himanivishwa/S3DUCKY/BOM/BOMS3DUCKY.csv

# | Reference | Part (from your BOM) | Footprint | Qty on board | Vendor | Product listed | Link | price | price in usd
1 | C1, C7 | 100nF | Capacitor_SMD:C_0805_2012Metric | 2 | Sharvi | 0.1uF/100nF 10V Capacitor – 0805 Package | https://sharvielectronics.com/product/0-1uf-100nf-10v-capacitor-0805-pack-of-10/ | 25 | 0.26
2 | C2, C5 | 10uF | Capacitor_SMD:C_0805_2012Metric | 2 | Sharvi | 10uF/10000nF 16V Capacitor – 0805 SMD Package | https://sharvielectronics.com/product/10uf-10000nf-16v-capacitor-%c2%b110-tolerance-0805x106k160ct-0805-package/ | 29.5 | 0.31
3 | C6 | 22uF | Capacitor_SMD:C_0805_2012Metric | 1 | Unsourced | 22uF 0805 X5R 10V | https://sharvielectronics.com/product/22uf-22000nf-50v-capacitor-%c2%b110-tolerance-0805b226k500ct-0805-package/ | 4.56 | 0.048
4 | D1 | RED LED | LED_SMD:LED_0805_2012Metric | 1 | Quartz | Red LED – SMD (0805 Package) – Pack of 50 | https://quartzcomponents.com/products/red-led-smd-0805-package-pack-of-50 | 25 | 0.26
5 | D2 | GREEN LED | LED_SMD:LED_0805_2012Metric | 1 | Quartz | Green LED – SMD (0805 Package) – Pack of 50 | https://quartzcomponents.com/collections/smd-leds/products/green-led-smd-0805-package-pack-of-50 | 24 | 0.26
6 | D3 | BLUE LED | LED_SMD:LED_0805_2012Metric | 1 | Quartz | Blue LED – SMD (0805 Package) – Pack of 50 | https://quartzcomponents.com/products/blue-led-smd-0805-package-pack-of-50 | 24 | 0.26
7 | J1, J3 | Conn_01x11_Pin (1x11 male header, 2.54 mm) | Connector_PinHeader_2.54mm:PinHeader_1x11_P2.54mm_Vertical | 2 | Unsourced | 1x40 break-away male header strip | n/a
8 | J2 | USB_A (male, through-hole) | usb_afoot:USB-AM-TH_AM90 | 1 | Robu | USB A-type Plug Male PCB R/A Connector (Pack of 5) | https://robu.in/product/usb-a-type-plug-male-pcb-r-a-connector-pack-of-5 | 5 | 0.053
9 | R3, R4, R5, R6 | 5.1k | Resistor_SMD:R_0805_2012Metric | 4 | Quartz | 5.1K ohm / 5K1 5% SMD Resistor 0805 (Pack of 20 Pieces) | https://quartzcomponents.com/collections/smd-resistors/products/5-1k-ohm-5k1-5-smd-resistor-0805-pack-of-20-pieces | 8 | 0.084
10 | SW1, SW2 | SW_Push (SMD tact switch ~3.9 × 3.0 mm) | smd_sw:SW-SMD_L3.9-W3.0-P4.45 | 2 | Unsourced | SMD tactile switch 3x4x2 mm (not found at the 4 shops) | https://robu.in/product/362-5mm-tactile-push-button-switch-20pcs/ | 25 | 0.26
11 | U1 | ESP32-S3-WROOM-1 | RF_Module:ESP32-S3-WROOM-1 | 1 | Robu | Espressif ESP32-S3-WROOM-1-N16R8 Module | https://robu.in/product/espressif-esp32-s3-wroom-1-n16r8-module | 449 | 4.73
12 | U2 | LD1117V (3.3 V, SOT-223 footprint) | Package_TO_SOT_SMD:SOT-223-3_TabPin2 | 1 | Robu | LM1117GS-3.3 – 3.3V 1A LDO regulator, SOT-223 (pin-compatible substitute) | https://robu.in/product/lm1117gs-3-3-3-3v-lm1117-1a-fixed-output-ldo-linear-voltage-regulator-4-pin-sot-223/ | 25 | 0.26
 |  |  |  |  |  | robu shipping |  | 49 | 0.52
 |  |  |  |  |  | quartz shipping + taxes |  | 74.58 | 0.79
 |  |  |  |  |  | sharvielectronics shipping + taxes |  | 68.2 | 0.72
 |  |  |  |  |  | jlc pcb |  | 379.78 | 4
 |  |  |  |  |  | pcb shipping |  | 626.64 | 6.6
 |  |  |  |  |  |  | Total | 1842.26 | 19.4
