himanivishwa/S3DUCKY/hardware/s3-ducky.kicad_pcb

## KiCad design hardware/s3-ducky.kicad_pcb (2026-10-26)

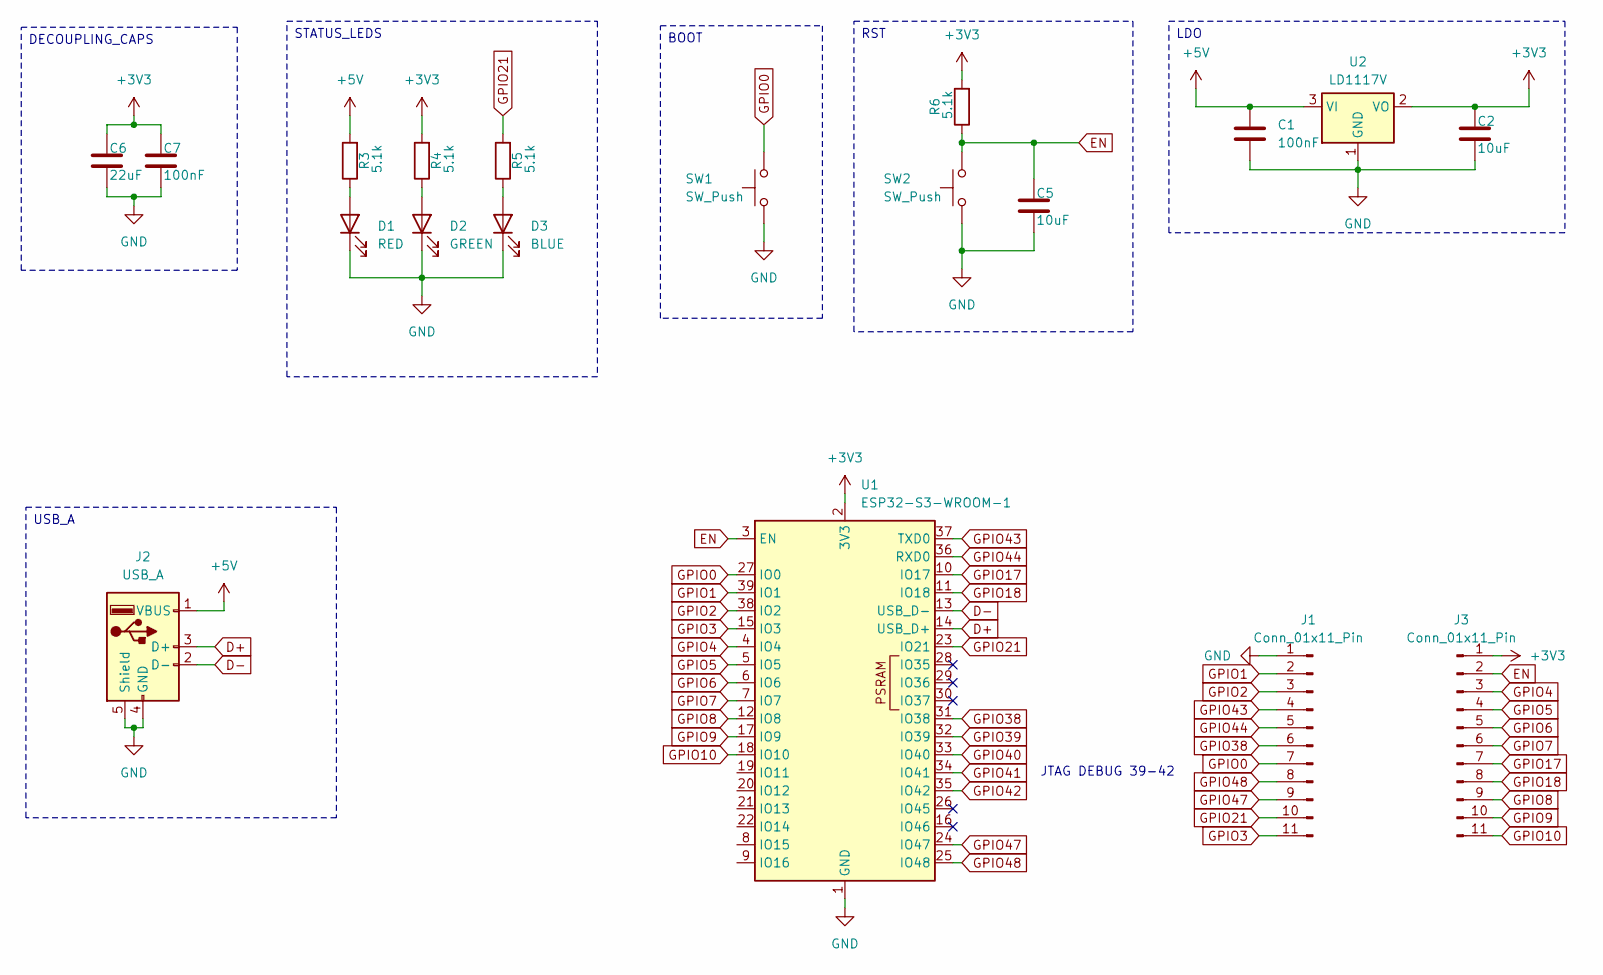
[picture p3: schematic s3-ducky.kicad_sch]

Parts:
C1, C7: 100nF; C_0805_2012Metric
C2, C5: 10uF; C_0805_2012Metric
C6: 22uF; C_0805_2012Metric
D1: RED; LED_0805_2012Metric
D2: GREEN; LED_0805_2012Metric
D3: BLUE; LED_0805_2012Metric
J1, J3: Conn_01x11_Pin; PinHeader_1x11_P2.54mm_Vertical
J2: USB_A; USB-AM-TH_AM90
R3, R4, R5, R6: 5.1k; R_0805_2012Metric
SW1, SW2: SW_Push; SW-SMD_L3.9-W3.0-P4.45
U1: ESP32-S3-WROOM-1
U2: LD1117V; SOT-223-3_TabPin2

Connections:
+3V3: C2.1, C6.1, C7.1, J3.1, R4.2, R6.2, U1.2 (3V3), U2.2 (VO)
+5V: C1.1, J2.1 (VBUS), R3.2, U2.3 (VI)
D+: J2.3 (D+), U1.14 (USB_D+)
D-: J2.2 (D-), U1.13 (USB_D-)
EN: C5.1, J3.2, R6.1, SW2.2, U1.3 (EN)
GND: C1.2, C2.2, C5.2, C6.2, C7.2, D1.1 (K), D2.1 (K), D3.1 (K), J1.1, J2.4 (GND), J2.5 (Shield), SW1.1, SW2.1, U1.1 (GND), U1.40 (GND), U1.41 (GND), U2.1 (GND)
GPIO0: J1.7, SW1.2, U1.27 (IO0)
GPIO1: J1.2, U1.39 (IO1)
GPIO2: J1.3, U1.38 (IO2)
GPIO3: J1.11, U1.15 (IO3)
GPIO4: J3.3, U1.4 (IO4)
GPIO5: J3.4, U1.5 (IO5)
GPIO6: J3.5, U1.6 (IO6)
GPIO7: J3.6, U1.7 (IO7)
GPIO8: J3.9, U1.12 (IO8)
GPIO9: J3.10, U1.17 (IO9)
GPIO10: J3.11, U1.18 (IO10)
GPIO17: J3.7, U1.10 (IO17)
GPIO18: J3.8, U1.11 (IO18)
GPIO21: J1.10, R5.2, U1.23 (IO21)
GPIO38: J1.6, U1.31 (IO38)
GPIO39: U1.32 (IO39)
GPIO40: U1.33 (IO40)
GPIO41: U1.34 (IO41)
GPIO42: U1.35 (IO42)
GPIO43: J1.4, U1.37 (TXD0)
GPIO44: J1.5, U1.36 (RXD0)
GPIO47: J1.9, U1.24 (IO47)
GPIO48: J1.8, U1.25 (IO48)
unnamed: D1.2 (A), R3.1
unnamed: D2.2 (A), R4.1
unnamed: D3.2 (A), R5.1

Notes on the sheet:
JTAG DEBUG 39-42
STATUS_LEDS
RST
USB_A
BOOT
LDO
DECOUPLING_CAPS

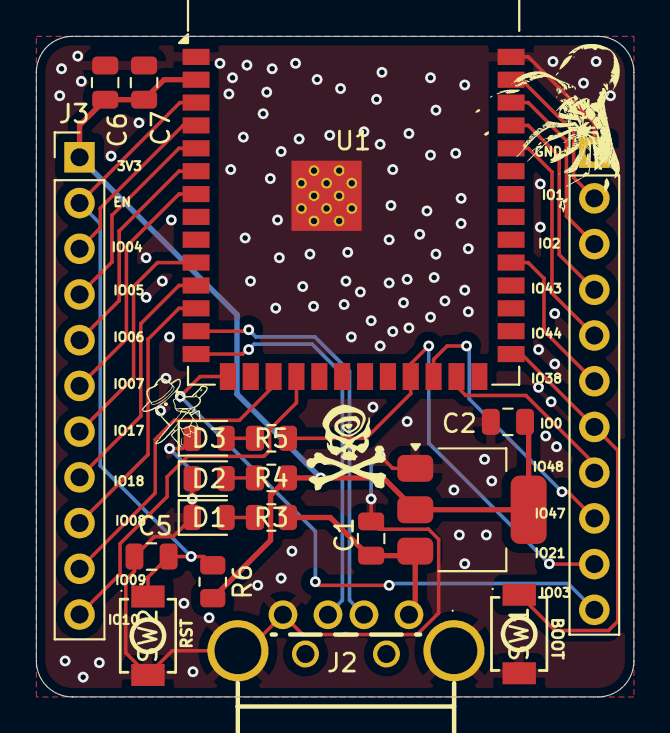
[picture p4: board s3-ducky.kicad_pcb from above]

Board: 2 copper layers, 33.2 x 36.7 mm, 19 parts (0 on the bottom side), 28 nets.
